adrienkohlbecker/BB816/simulation/README.md

# Simulation

## Address decoding

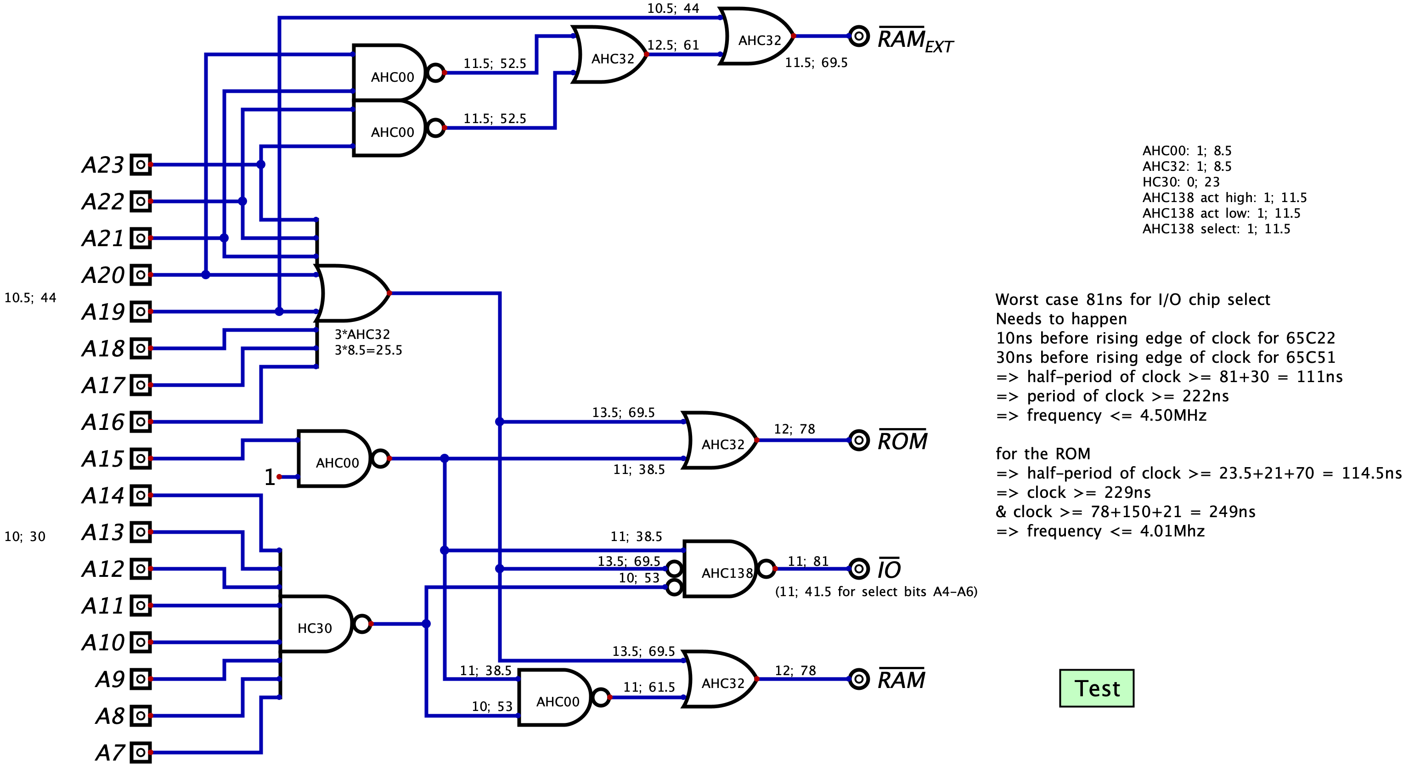
[picture p31: simulation/address.png]
Address decoding


## Glue logic

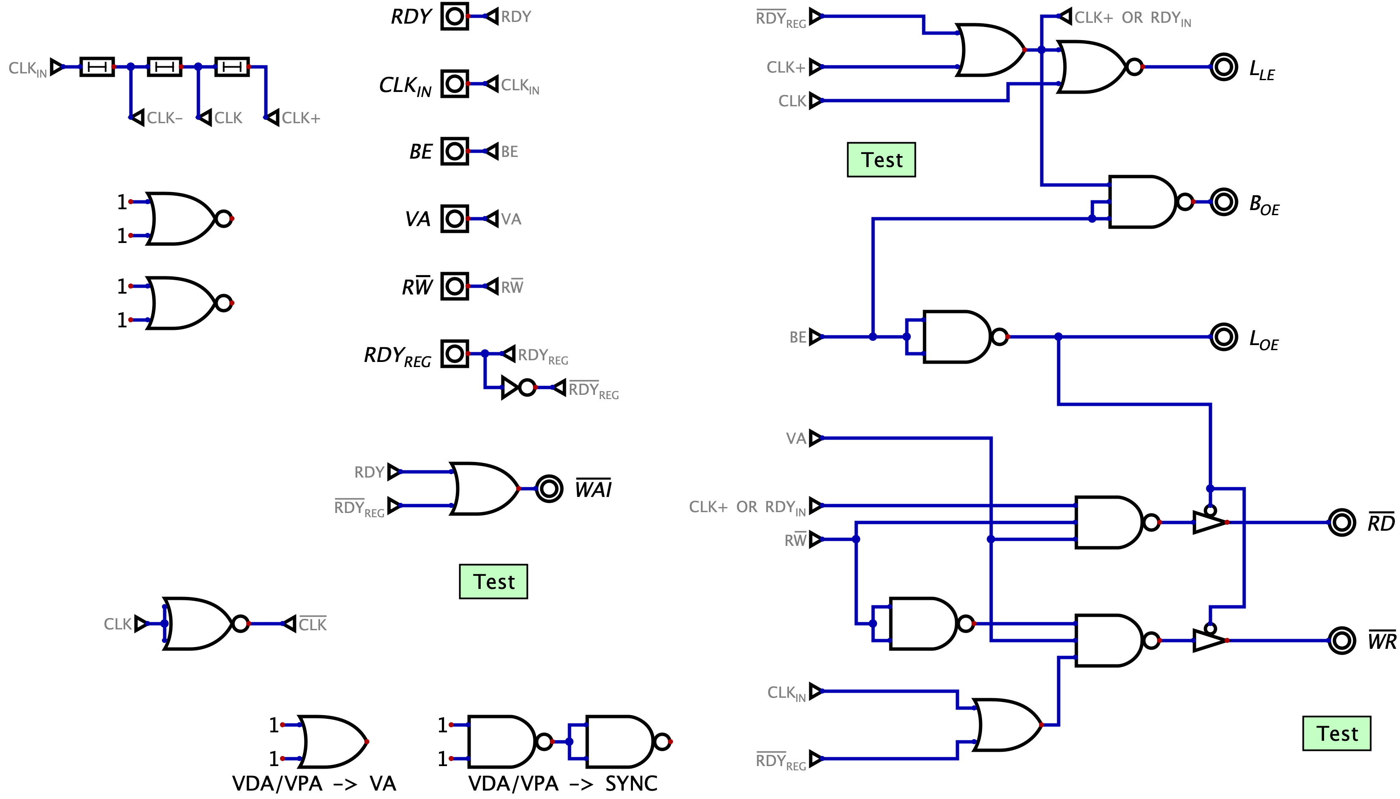
[picture p32: simulation/glue.png]
Glue logic
