adrienkohlbecker/BB816/hardware/breakout/timing/Timing BE.png

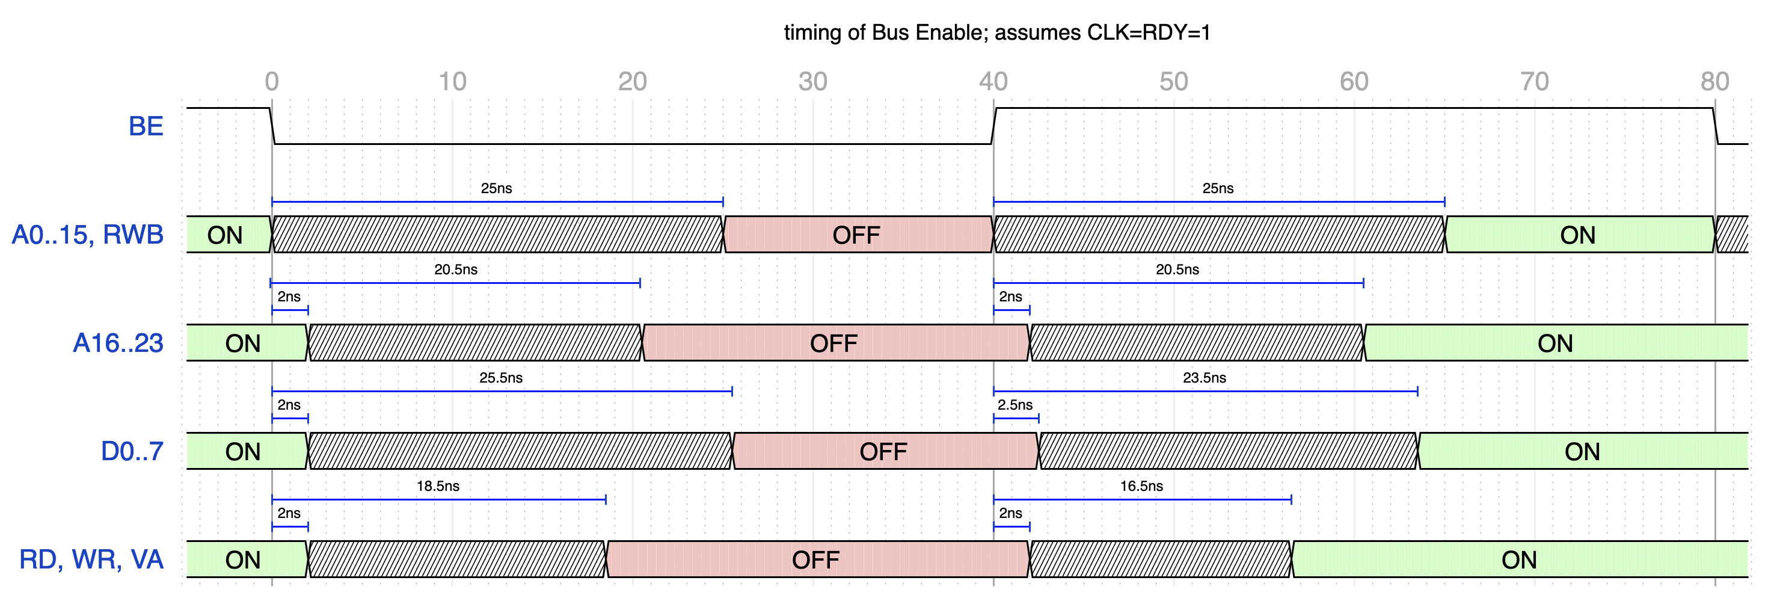
hardware/breakout/timing/Timing BE.png
