adrienkohlbecker/BB816/hardware/breakout/timing/Timing Main.png

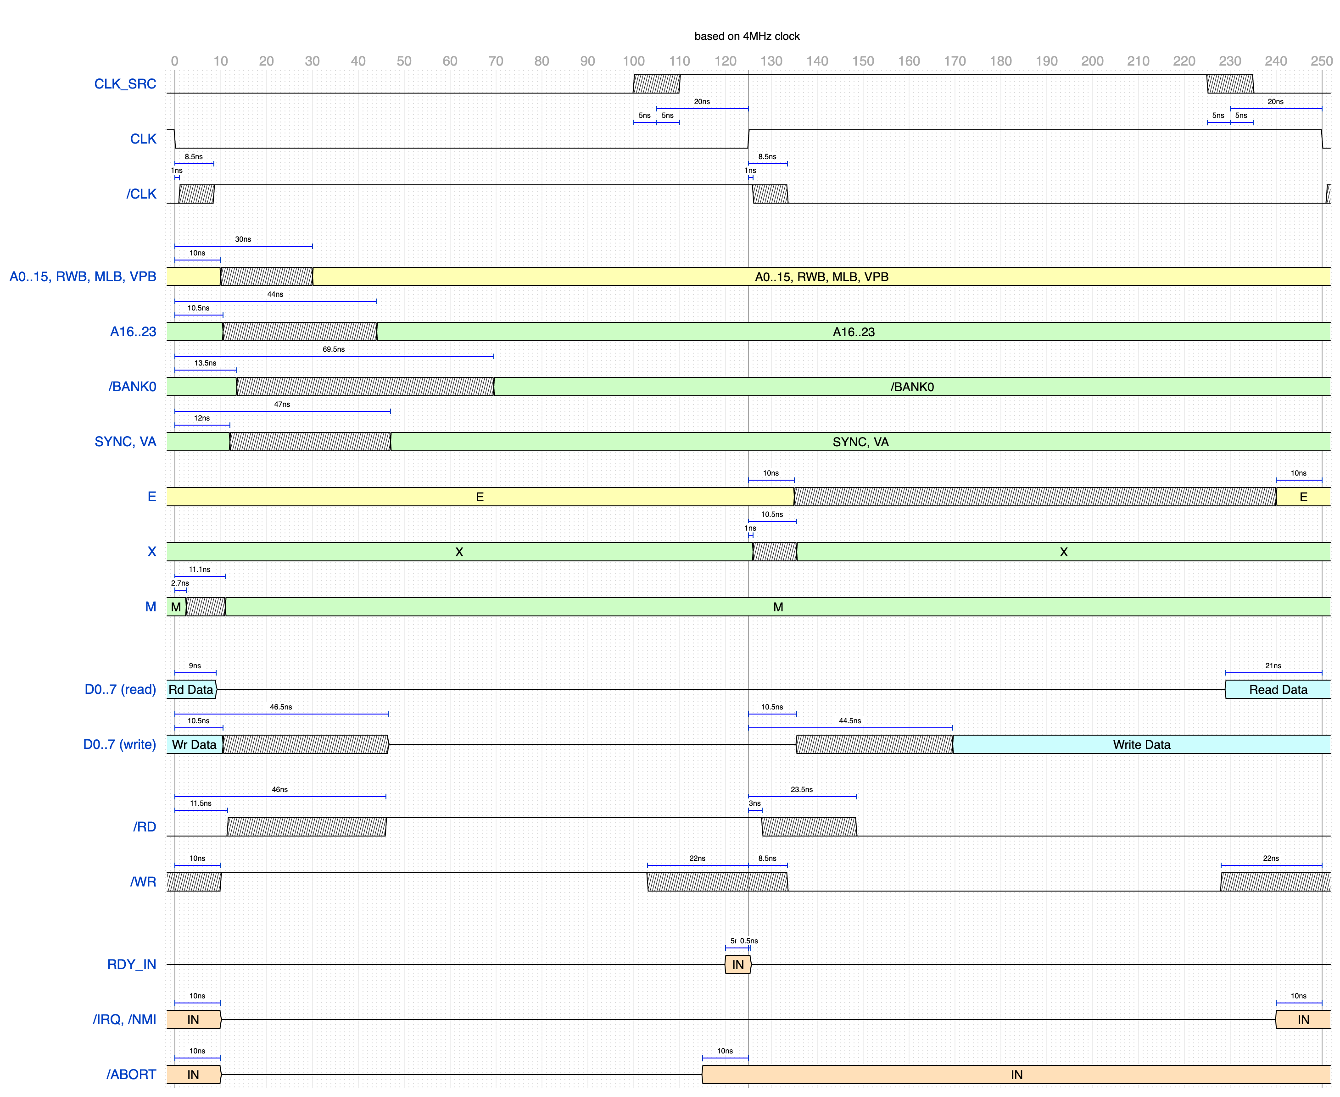
hardware/breakout/timing/Timing Main.png
