adrienkohlbecker/BB816/thumbnails/0.jpg

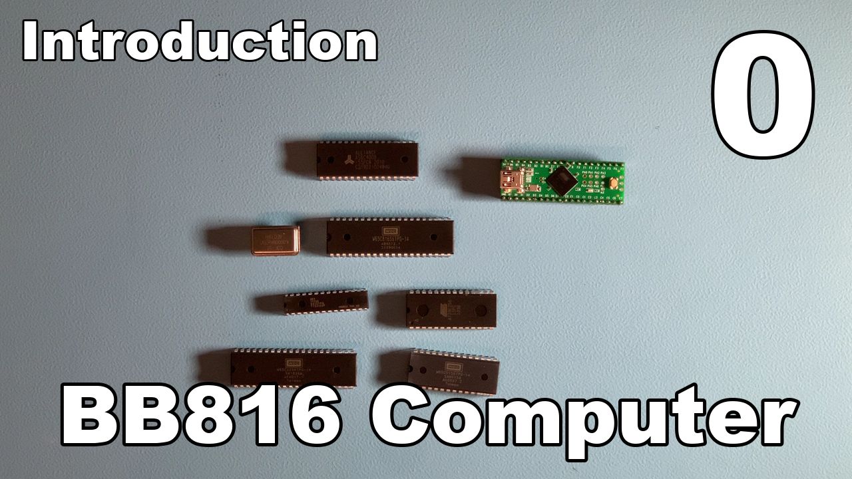
thumbnails/0.jpg
