adrienkohlbecker/BB816/thumbnails/1.jpg

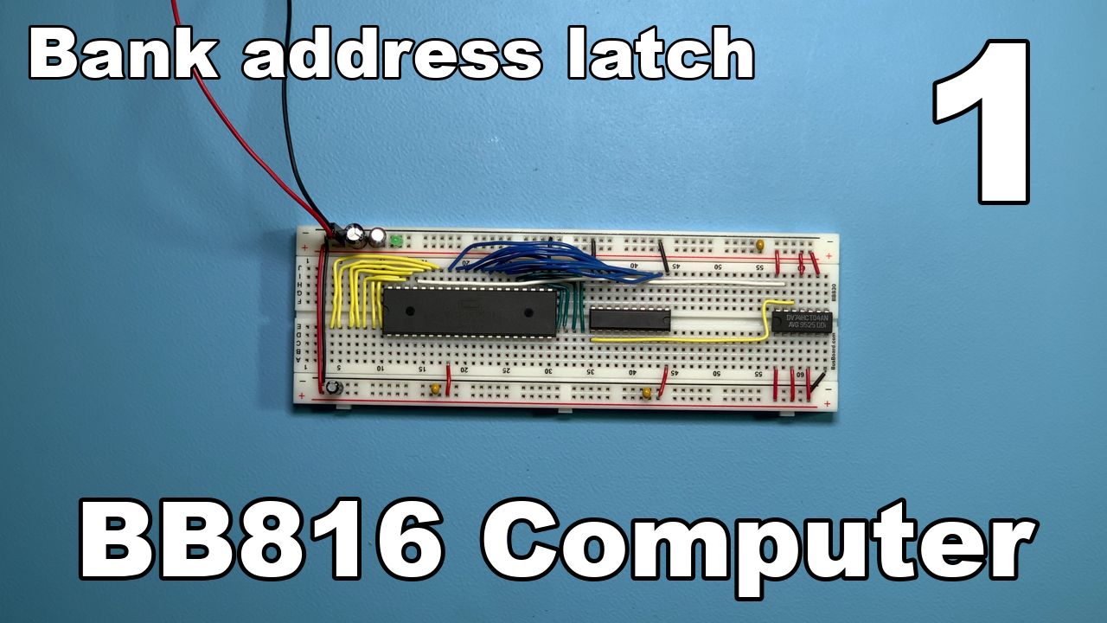
thumbnails/1.jpg
