adrienkohlbecker/BB816/thumbnails/2.jpg

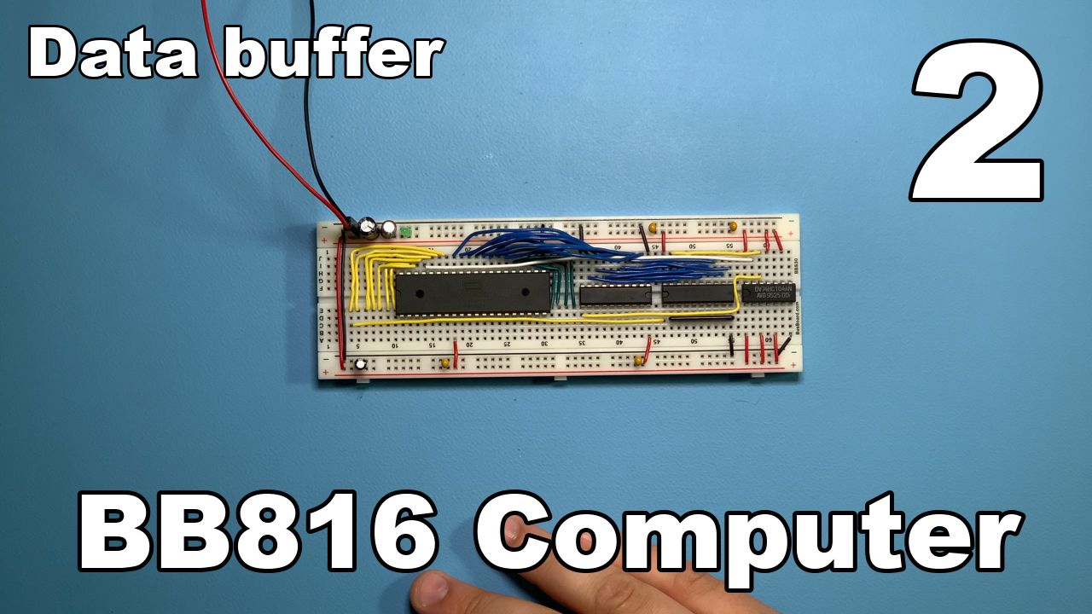
thumbnails/2.jpg
