adrienkohlbecker/BB816/thumbnails/3.jpg

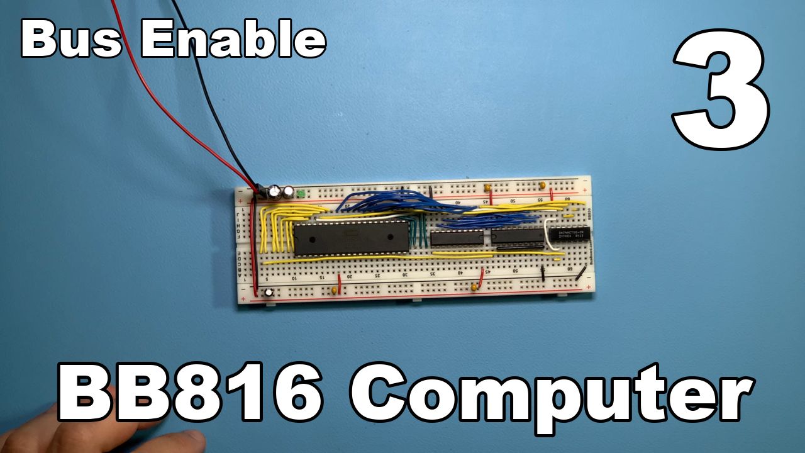
thumbnails/3.jpg
