adrienkohlbecker/BB816/thumbnails/4.jpg

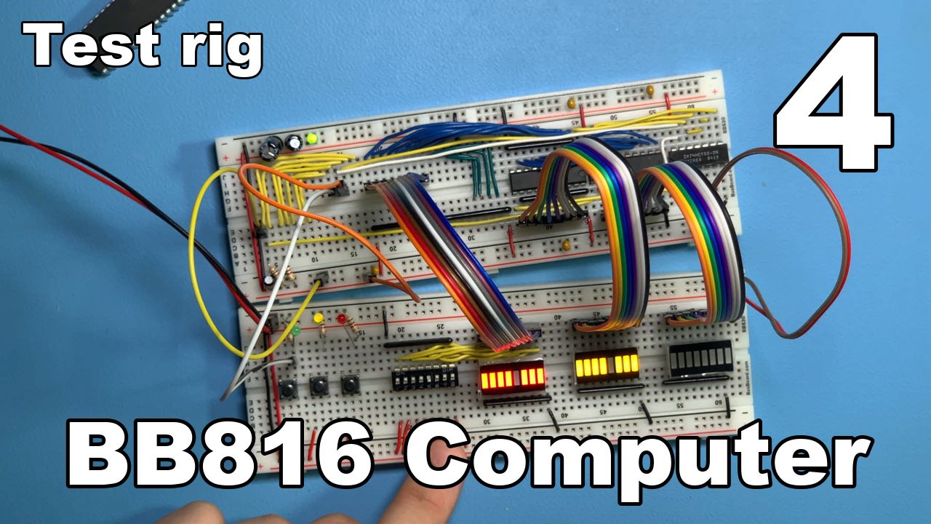
thumbnails/4.jpg
