adrienkohlbecker/BB816/thumbnails/5.jpg

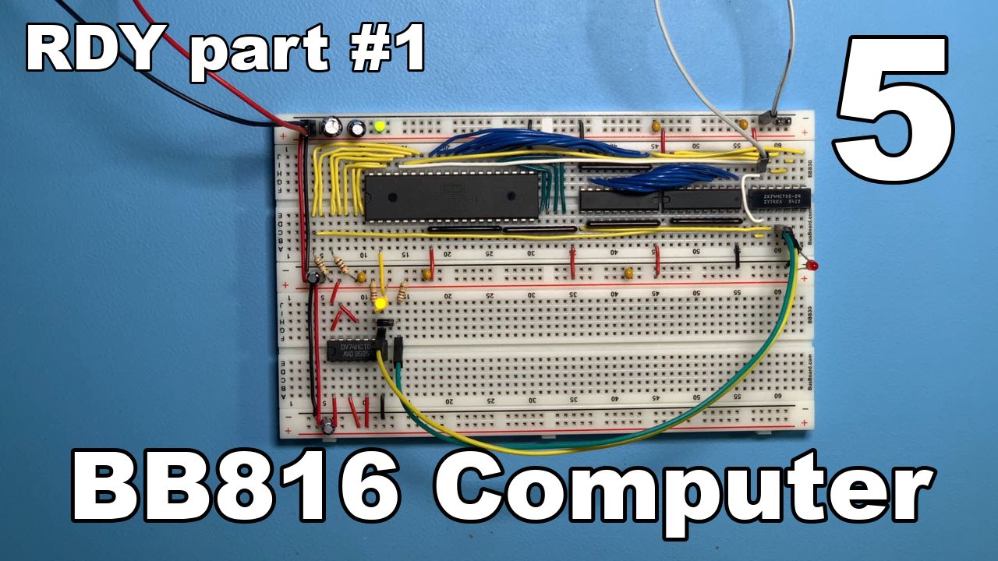
thumbnails/5.jpg
