adrienkohlbecker/BB816/thumbnails/6.jpg

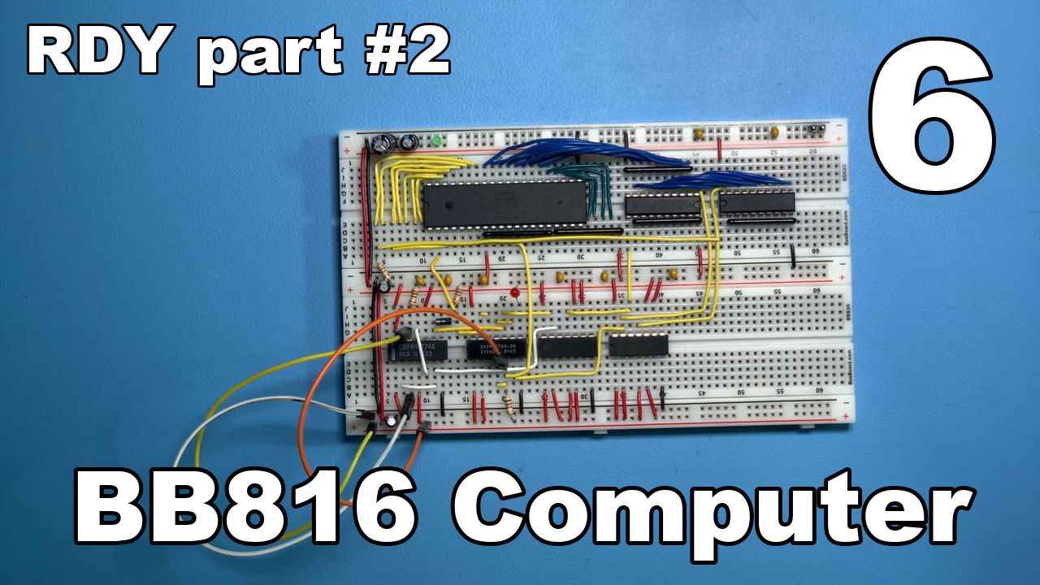
thumbnails/6.jpg
