adrienkohlbecker/BB816/thumbnails/7.jpg

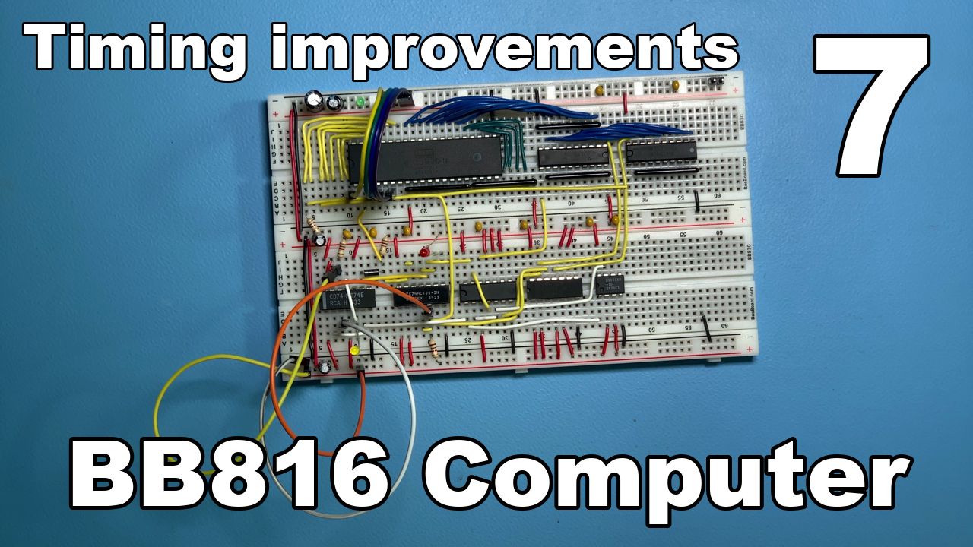
thumbnails/7.jpg
