adrienkohlbecker/BB816/thumbnails/8.jpg

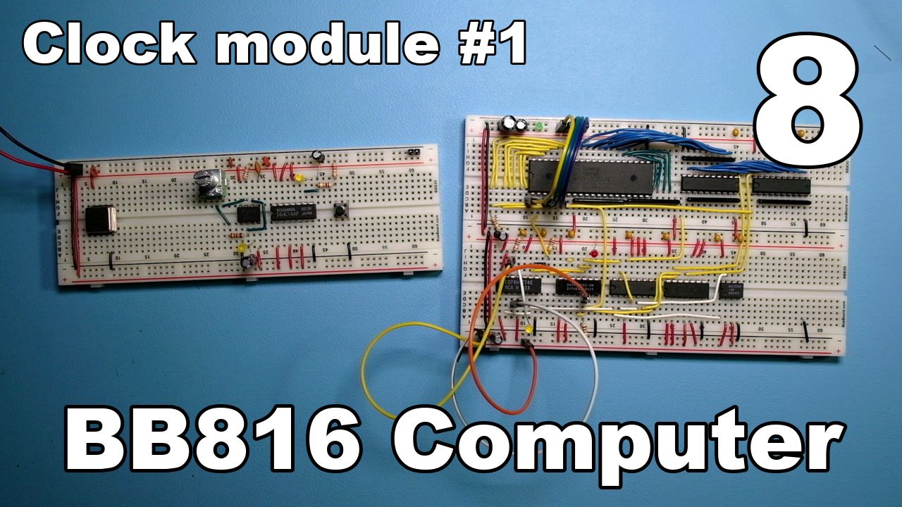
thumbnails/8.jpg
