adrienkohlbecker/BB816/thumbnails/9.jpg

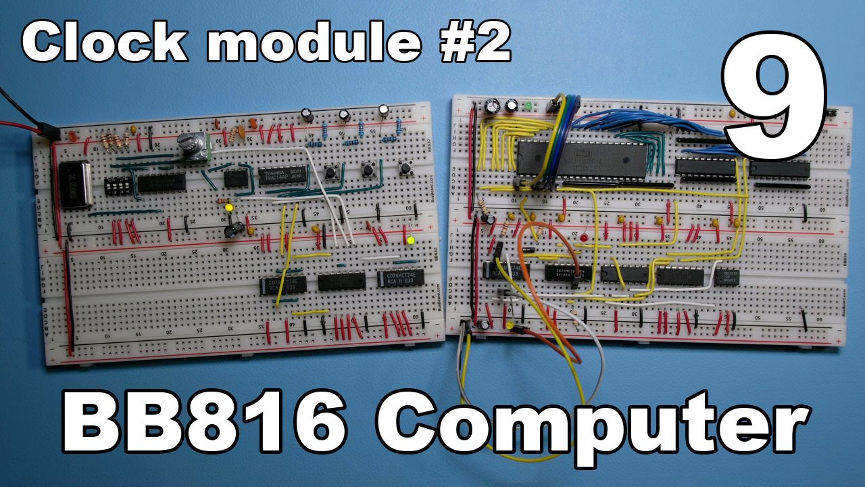
thumbnails/9.jpg
