adrienkohlbecker/BB816/thumbnails/10.jpg

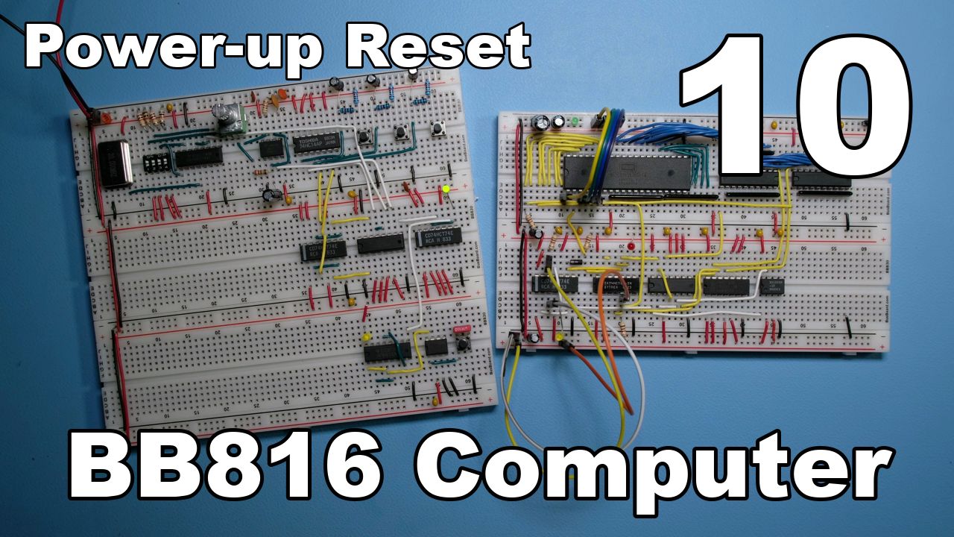
thumbnails/10.jpg
