adrienkohlbecker/BB816/thumbnails/11.jpg

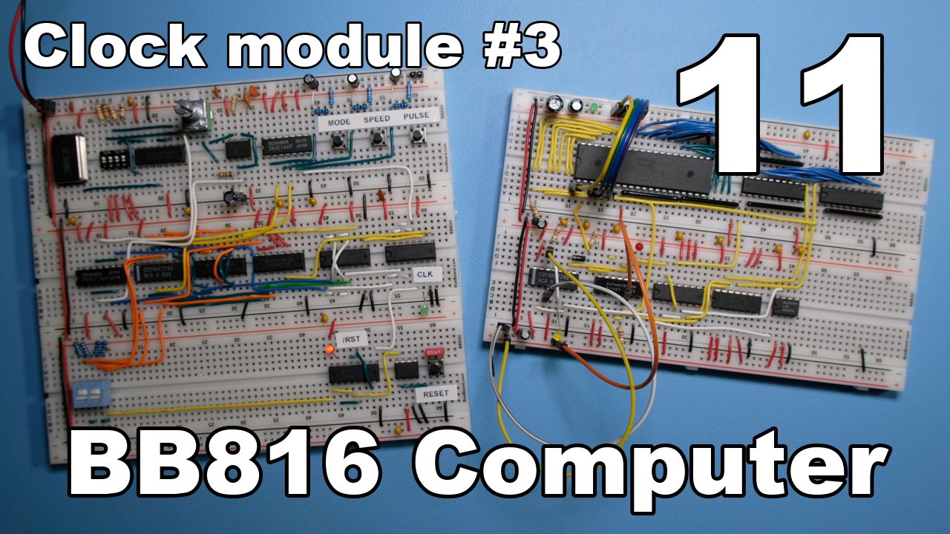
thumbnails/11.jpg
