adrienkohlbecker/BB816/thumbnails/12.jpg

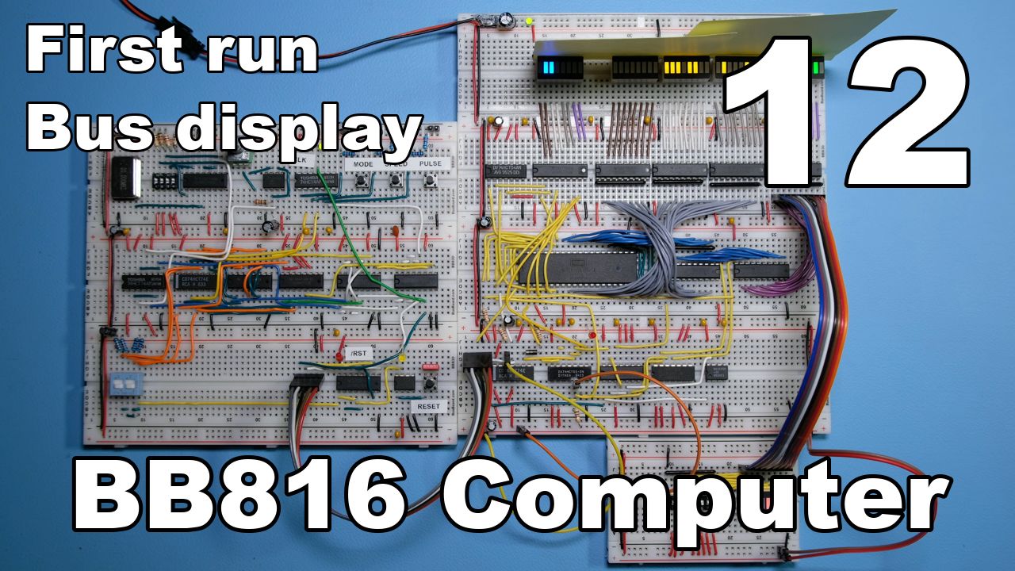
thumbnails/12.jpg
