adrienkohlbecker/BB816/thumbnails/13.jpg

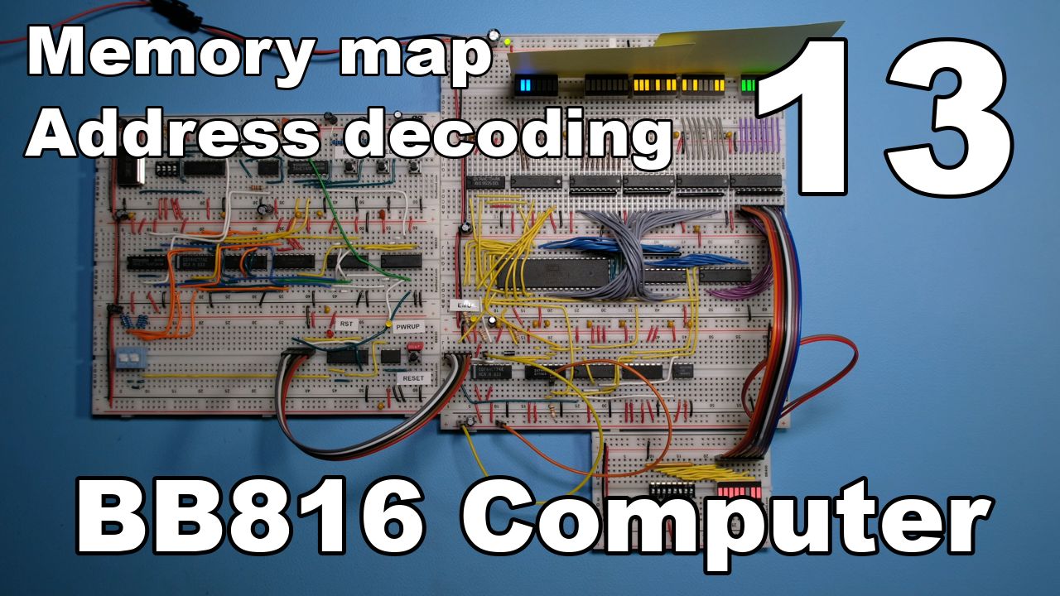
thumbnails/13.jpg
