adrienkohlbecker/BB816/thumbnails/14.jpg

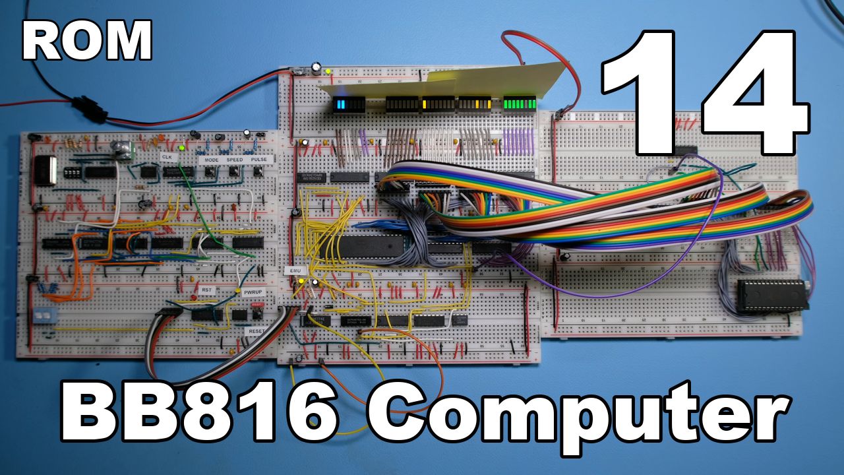
thumbnails/14.jpg
