adrienkohlbecker/BB816/thumbnails/15.jpg

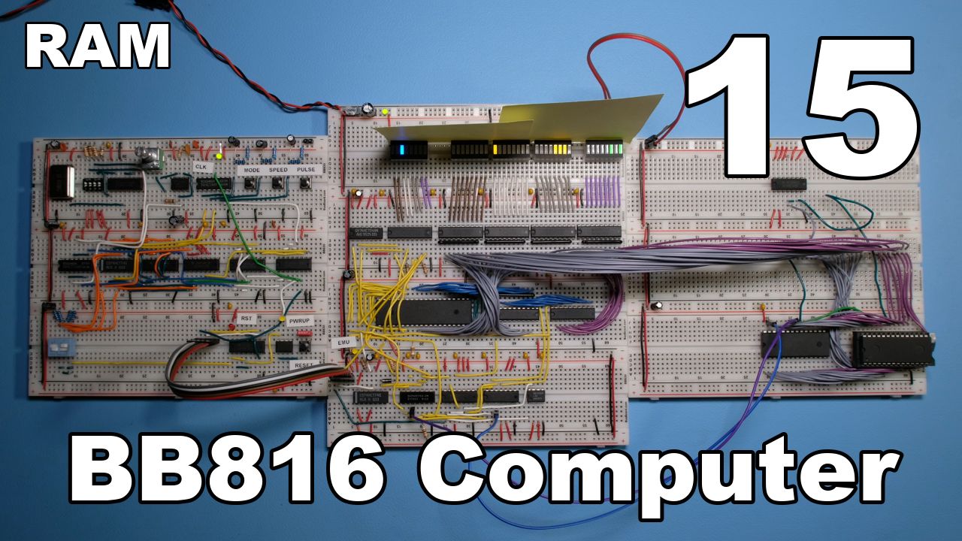
thumbnails/15.jpg
