adrienkohlbecker/BB816/thumbnails/16.jpg

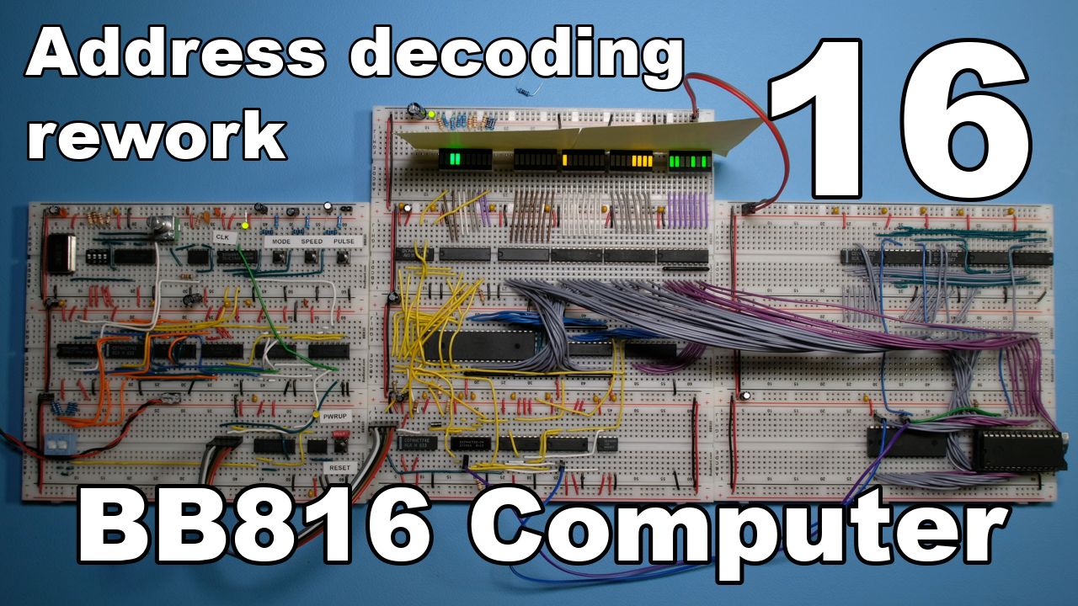
thumbnails/16.jpg
