adrienkohlbecker/BB816/thumbnails/17.jpg

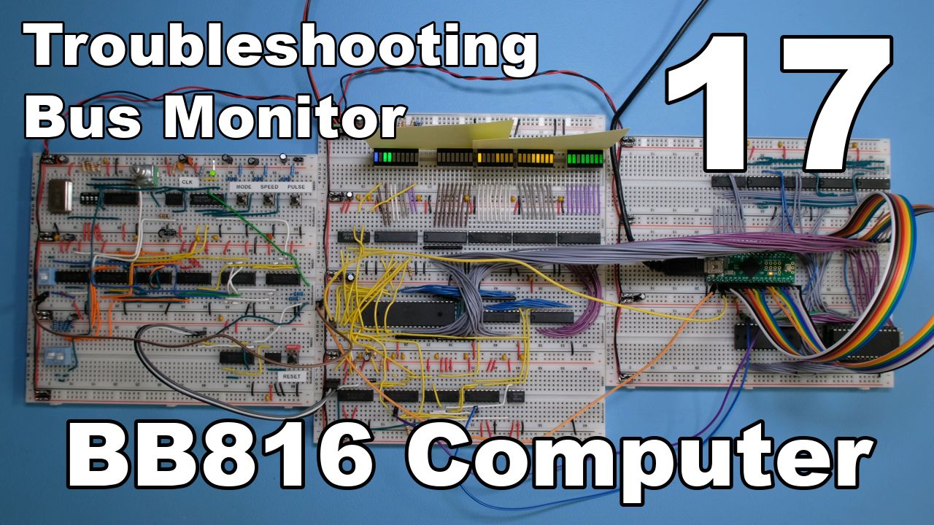
thumbnails/17.jpg
