adrienkohlbecker/BB816/thumbnails/18.jpg

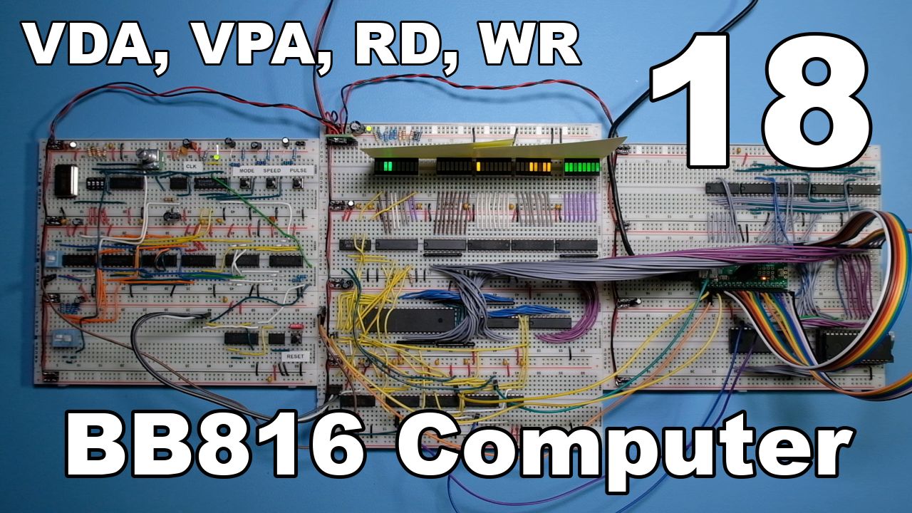
thumbnails/18.jpg
