adrienkohlbecker/BB816/thumbnails/19.jpg

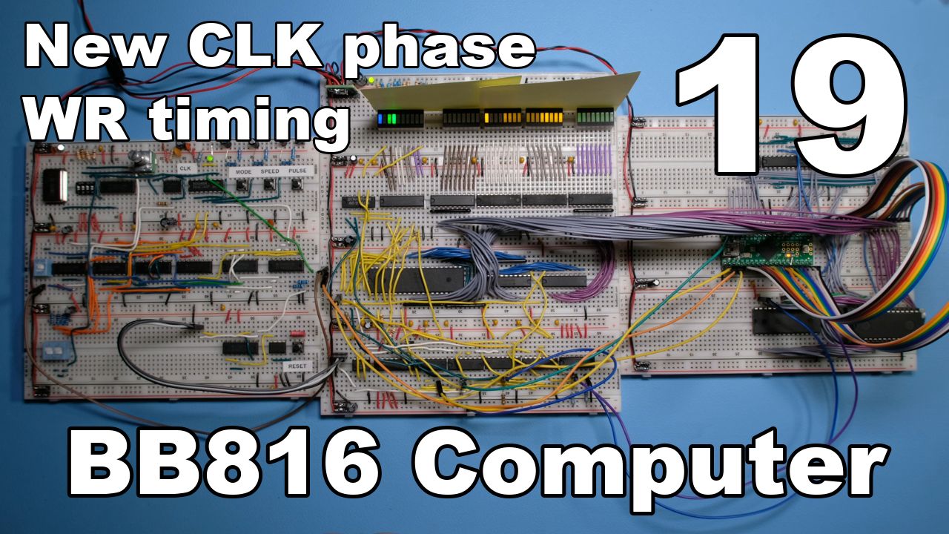
thumbnails/19.jpg
