adrienkohlbecker/BB816/thumbnails/20.jpg

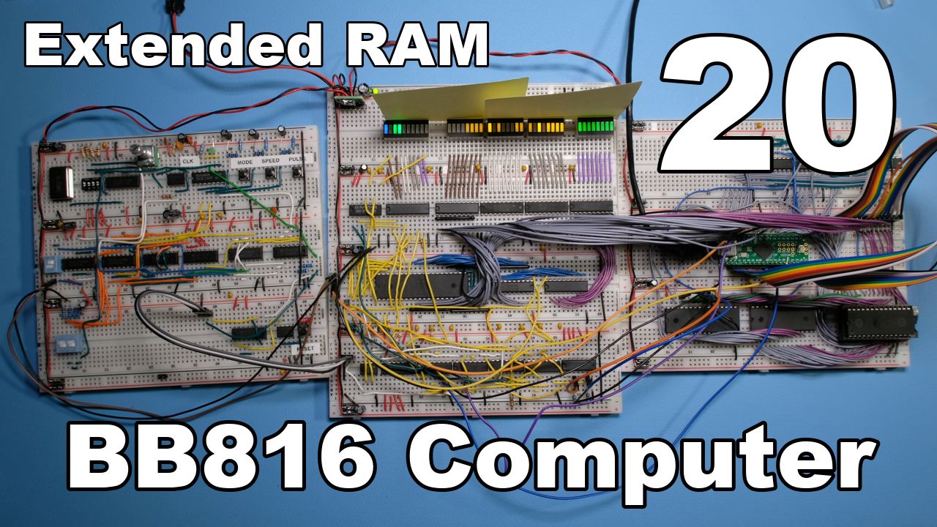
thumbnails/20.jpg
