adrienkohlbecker/BB816/thumbnails/21.jpg

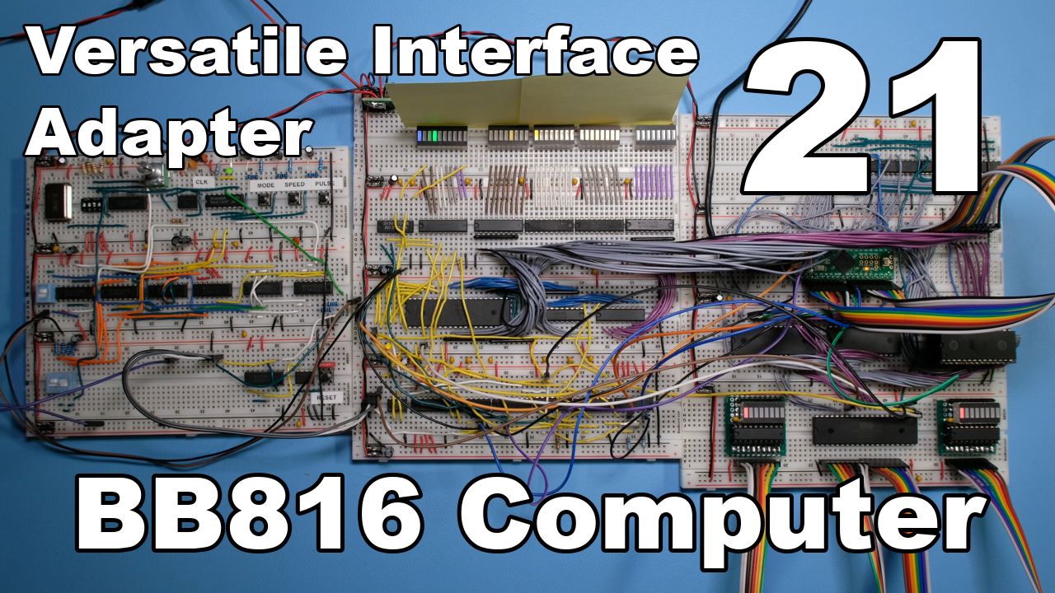
thumbnails/21.jpg
