adrienkohlbecker/BB816/thumbnails/22.jpg

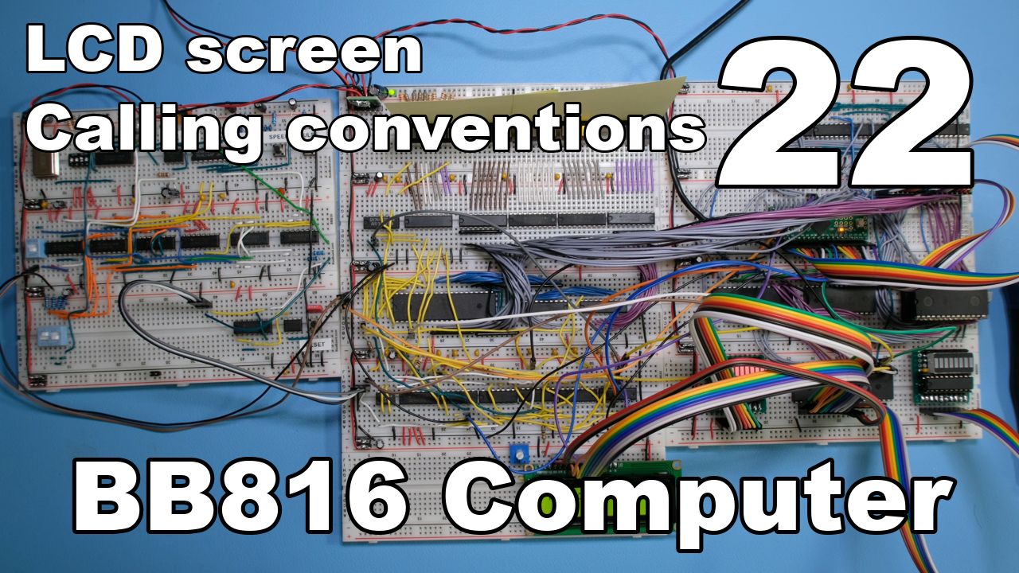
thumbnails/22.jpg
