adrienkohlbecker/BB816/thumbnails/23.jpg

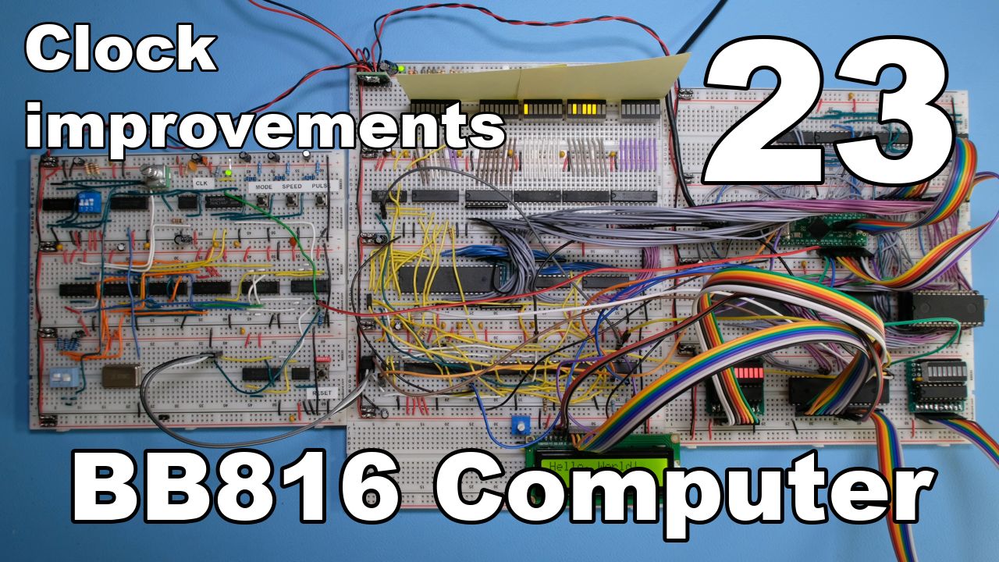
thumbnails/23.jpg
