adrienkohlbecker/BB816/thumbnails/24.jpg

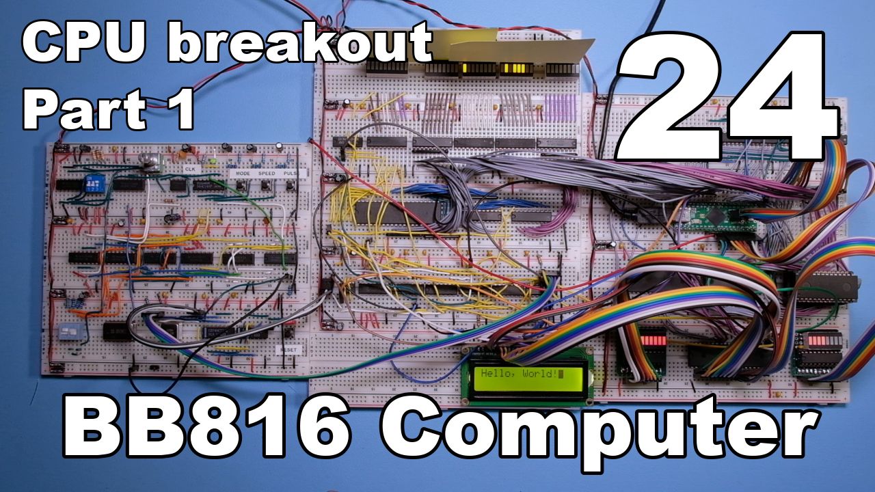
thumbnails/24.jpg
