adrienkohlbecker/BB816/thumbnails/25.jpg

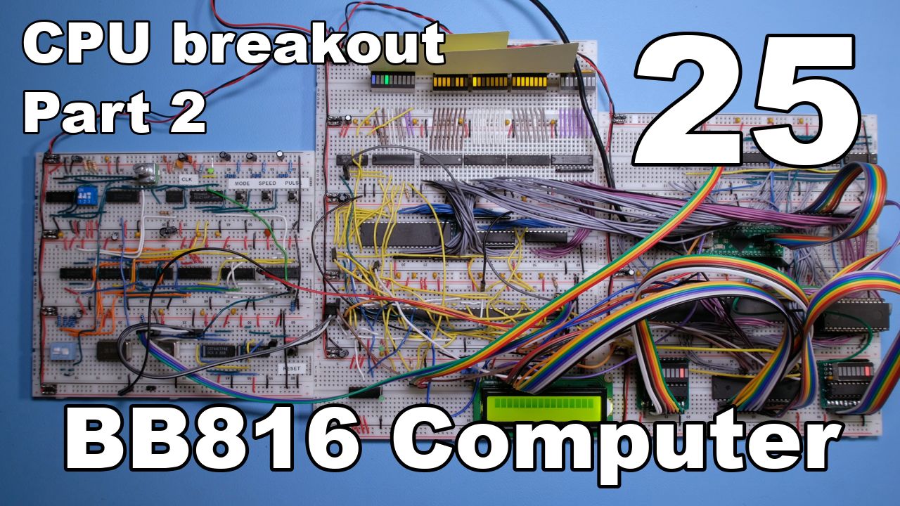
thumbnails/25.jpg
