adrienkohlbecker/BB816/thumbnails/26.jpg

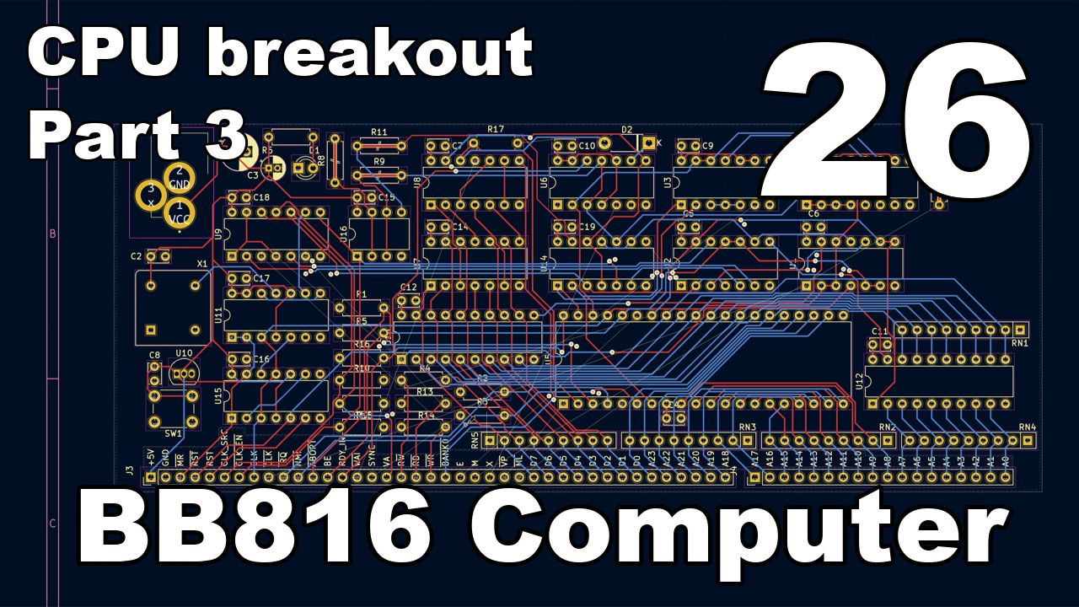
thumbnails/26.jpg
