adrienkohlbecker/BB816/thumbnails/27.jpg

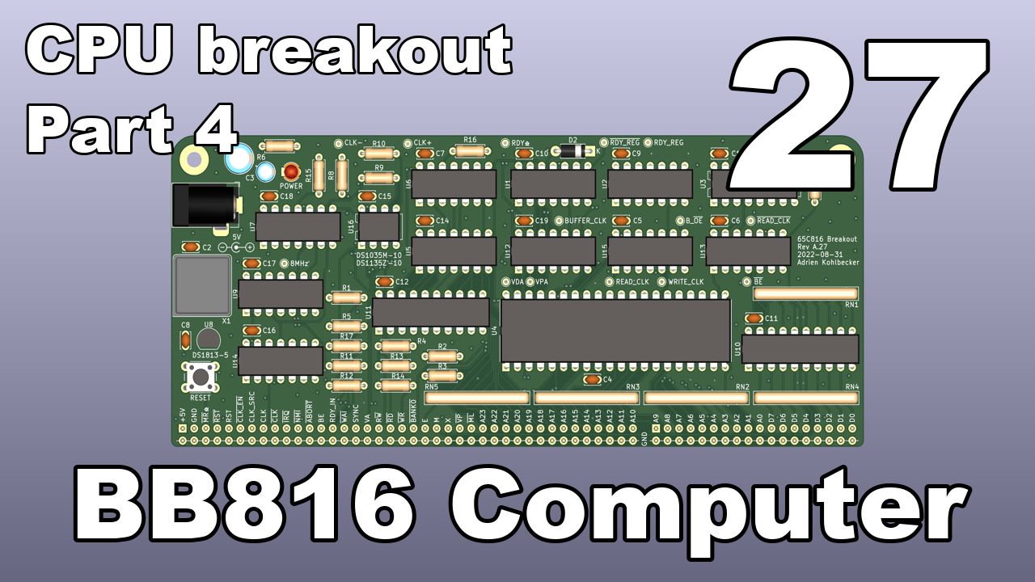
thumbnails/27.jpg
