adrienkohlbecker/BB816/thumbnails/28.jpg

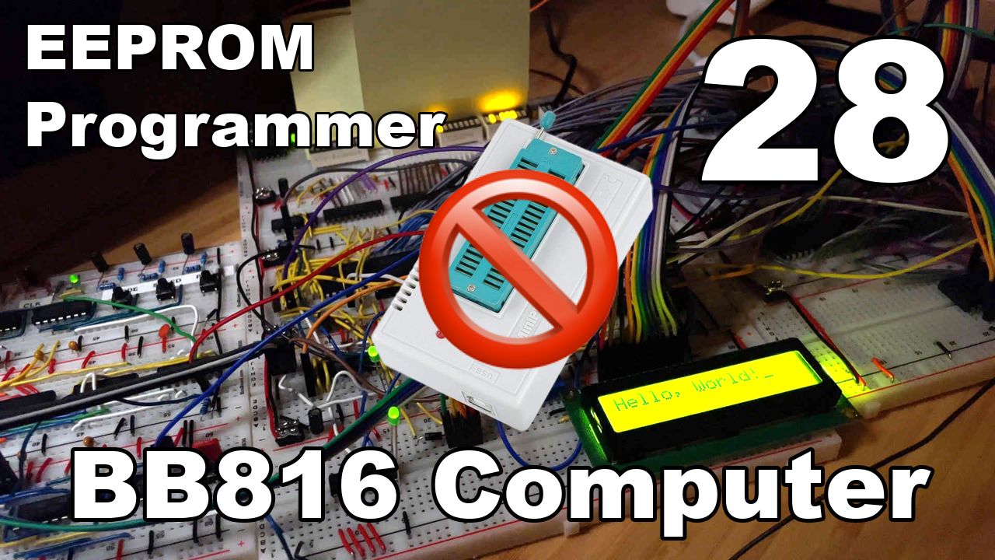
thumbnails/28.jpg
