adrienkohlbecker/BB816/thumbnails/29.jpg

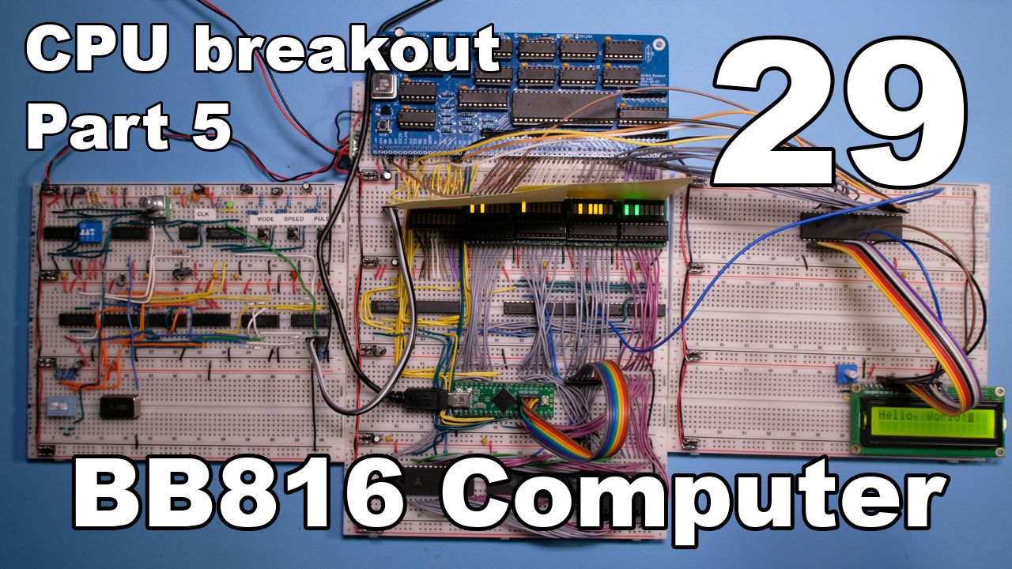
thumbnails/29.jpg
