adrienkohlbecker/BB816/thumbnails/30.jpg

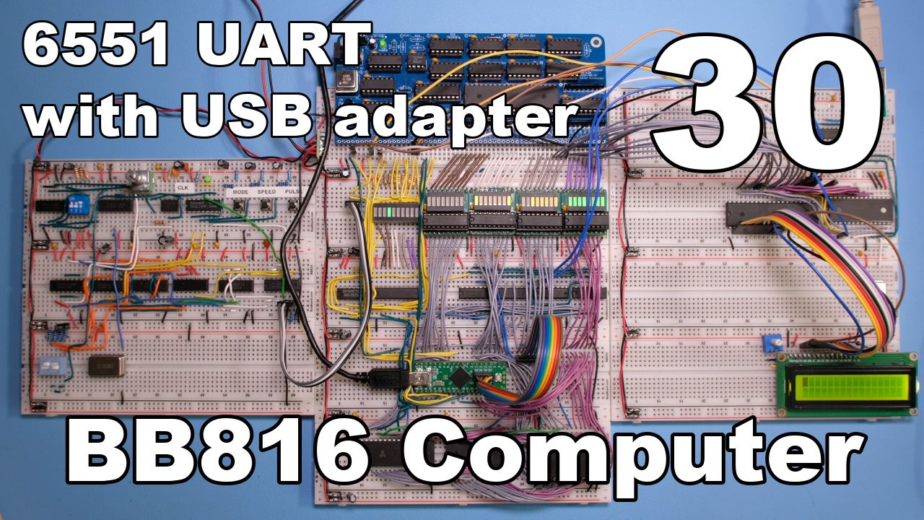
thumbnails/30.jpg
