adrienkohlbecker/BB816/thumbnails/31.jpg

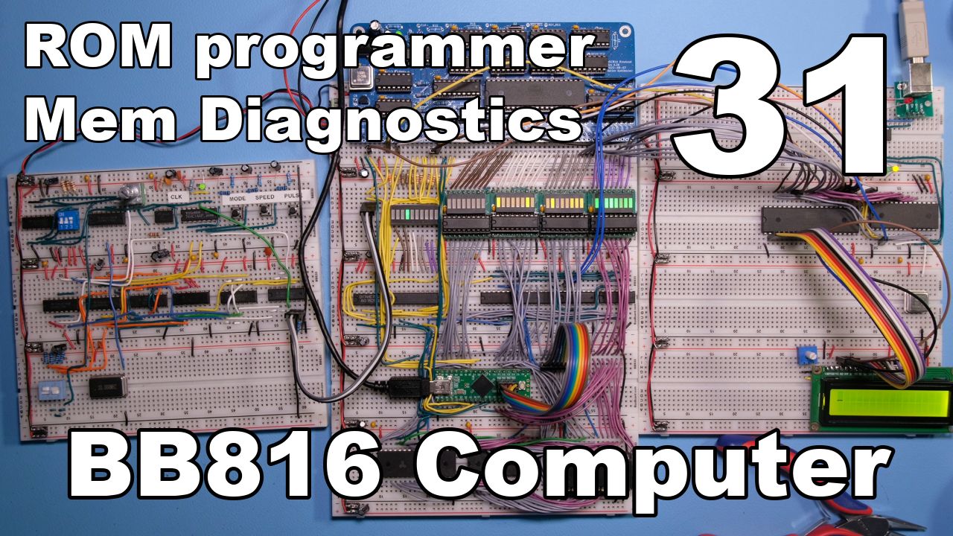
thumbnails/31.jpg
