adrienkohlbecker/BB816/thumbnails/32.jpg

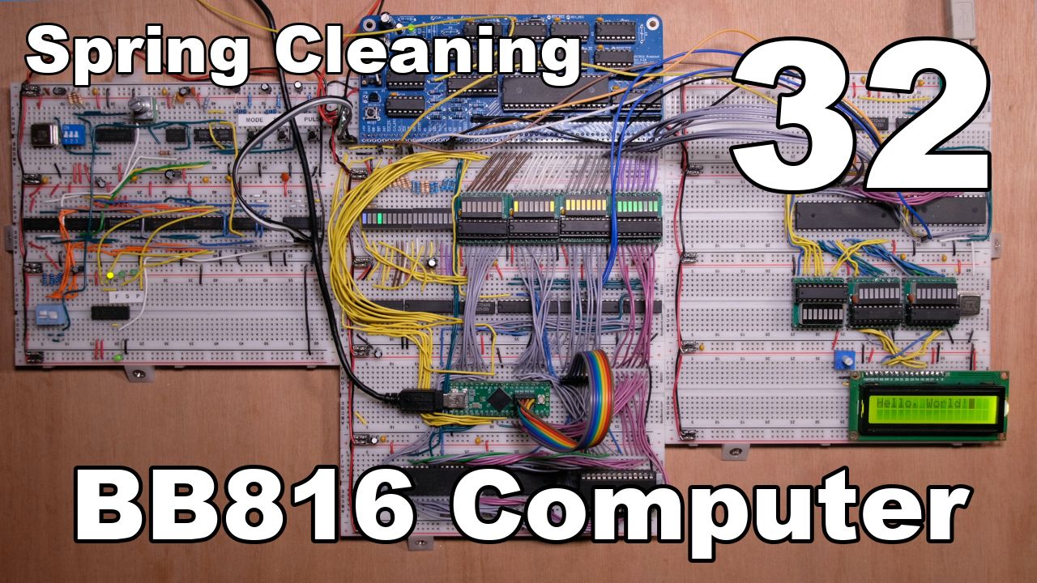
thumbnails/32.jpg
