adrienkohlbecker/BB816/hardware/debug_leds/3d/BAR-8-RYG.step

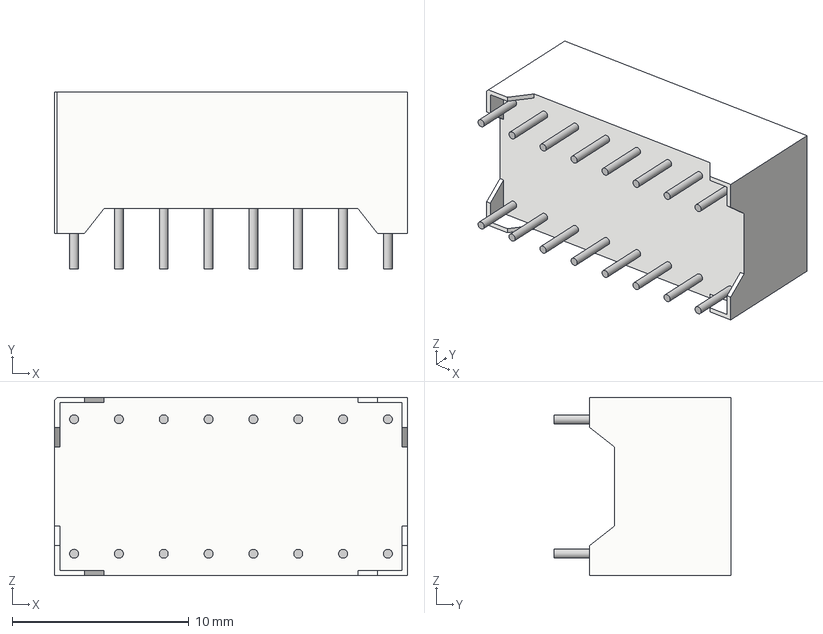
[picture p68: CAD file, 2023-08-10]
hardware/debug_leds/3d/BAR-8-RYG.step
20.0 x 10.0 x 10.1 mm
LED Bar Graph Red LDA-B8ZX v1 x 2
LED Bar Graph Red LDA-B8ZX v002 x 2
LED Bar Graph Red LDA-B8ZX v003 x 2
LED Bar Graph Red LDA-B8ZX v004 x 2
LED Bar Graph Red LDA-B8ZX v005 x 2
LED Bar Graph Red LDA-B8ZX v006 x 2
LED Bar Graph Red LDA-B8ZX v007 x 2
LED Bar Graph Red LDA-B8ZX v008 x 2
LED Bar Graph Red LDA-B8ZX v009 x 2
LED Bar Graph Red LDA-B8ZX v010 x 2
LED Bar Graph Red LDA-B8ZX v011 x 2
LED Bar Graph Red LDA-B8ZX v012 x 2
LED Bar Graph Red LDA-B8ZX v013 x 2
LED Bar Graph Red LDA-B8ZX v014 x 2
LED Bar Graph Red LDA-B8ZX v015 x 2
LED Bar Graph Red LDA-B8ZX v016 x 2
LED Bar Graph Red LDA-B8ZX v017 x 2
LED Bar Graph Red LDA-B8ZX v018 x 2
LED Bar Graph Red LDA-B8ZX v019 x 2
LED Bar Graph Red LDA-B8ZX v020 x 2
LED Bar Graph Red LDA-B8ZX v021 x 2
LED Bar Graph Red LDA-B8ZX v022 x 2
LED Bar Graph Red LDA-B8ZX v023 x 2
LED Bar Graph Red LDA-B8ZX v024 x 2
LED Bar Graph Red LDA-B8ZX v025 x 2
