adrienkohlbecker/BB816/hardware/debug_leds/3d/BAR-10-BRYG.step

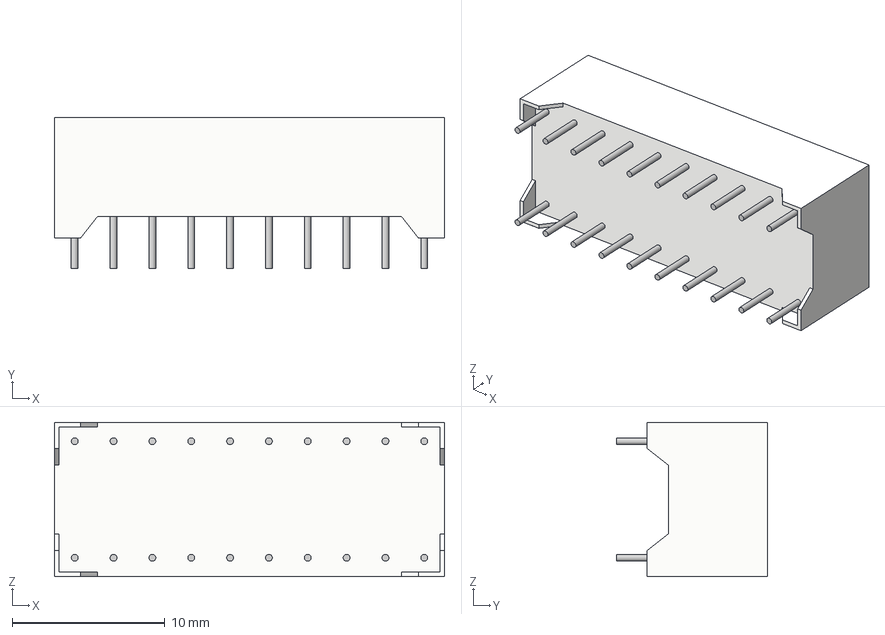
[picture p69: CAD file, 2023-08-10]
hardware/debug_leds/3d/BAR-10-BRYG.step
25.5 x 9.90 x 10.1 mm
LED Bar Graph 102510 Coloured v5
LED Bar Graph 102510 Coloured v006
LED Bar Graph 102510 Coloured v007
LED Bar Graph 102510 Coloured v008
LED Bar Graph 102510 Coloured v009
LED Bar Graph 102510 Coloured v010
LED Bar Graph 102510 Coloured v011
LED Bar Graph 102510 Coloured v012
LED Bar Graph 102510 Coloured v013
LED Bar Graph 102510 Coloured v014
LED Bar Graph 102510 Coloured v015
LED Bar Graph 102510 Coloured v016
LED Bar Graph 102510 Coloured v017
LED Bar Graph 102510 Coloured v018
LED Bar Graph 102510 Coloured v019
LED Bar Graph 102510 Coloured v020
LED Bar Graph 102510 Coloured v021
LED Bar Graph 102510 Coloured v022
LED Bar Graph 102510 Coloured v023
LED Bar Graph 102510 Coloured v024
LED Bar Graph 102510 Coloured v025
LED Bar Graph 102510 Coloured v026
LED Bar Graph 102510 Coloured v027
LED Bar Graph 102510 Coloured v028
LED Bar Graph 102510 Coloured v029
LED Bar Graph 102510 Coloured v030
LED Bar Graph 102510 Coloured v031
LED Bar Graph 102510 Coloured v032
LED Bar Graph 102510 Coloured v033
LED Bar Graph 102510 Coloured v034
LED Bar Graph 102510 Coloured v035
