adrienkohlbecker/BB816/hardware/debug_leds/debug_leds.kicad_pcb

## KiCad design hardware/debug_leds/debug_leds.kicad_pcb (2023-08-10)

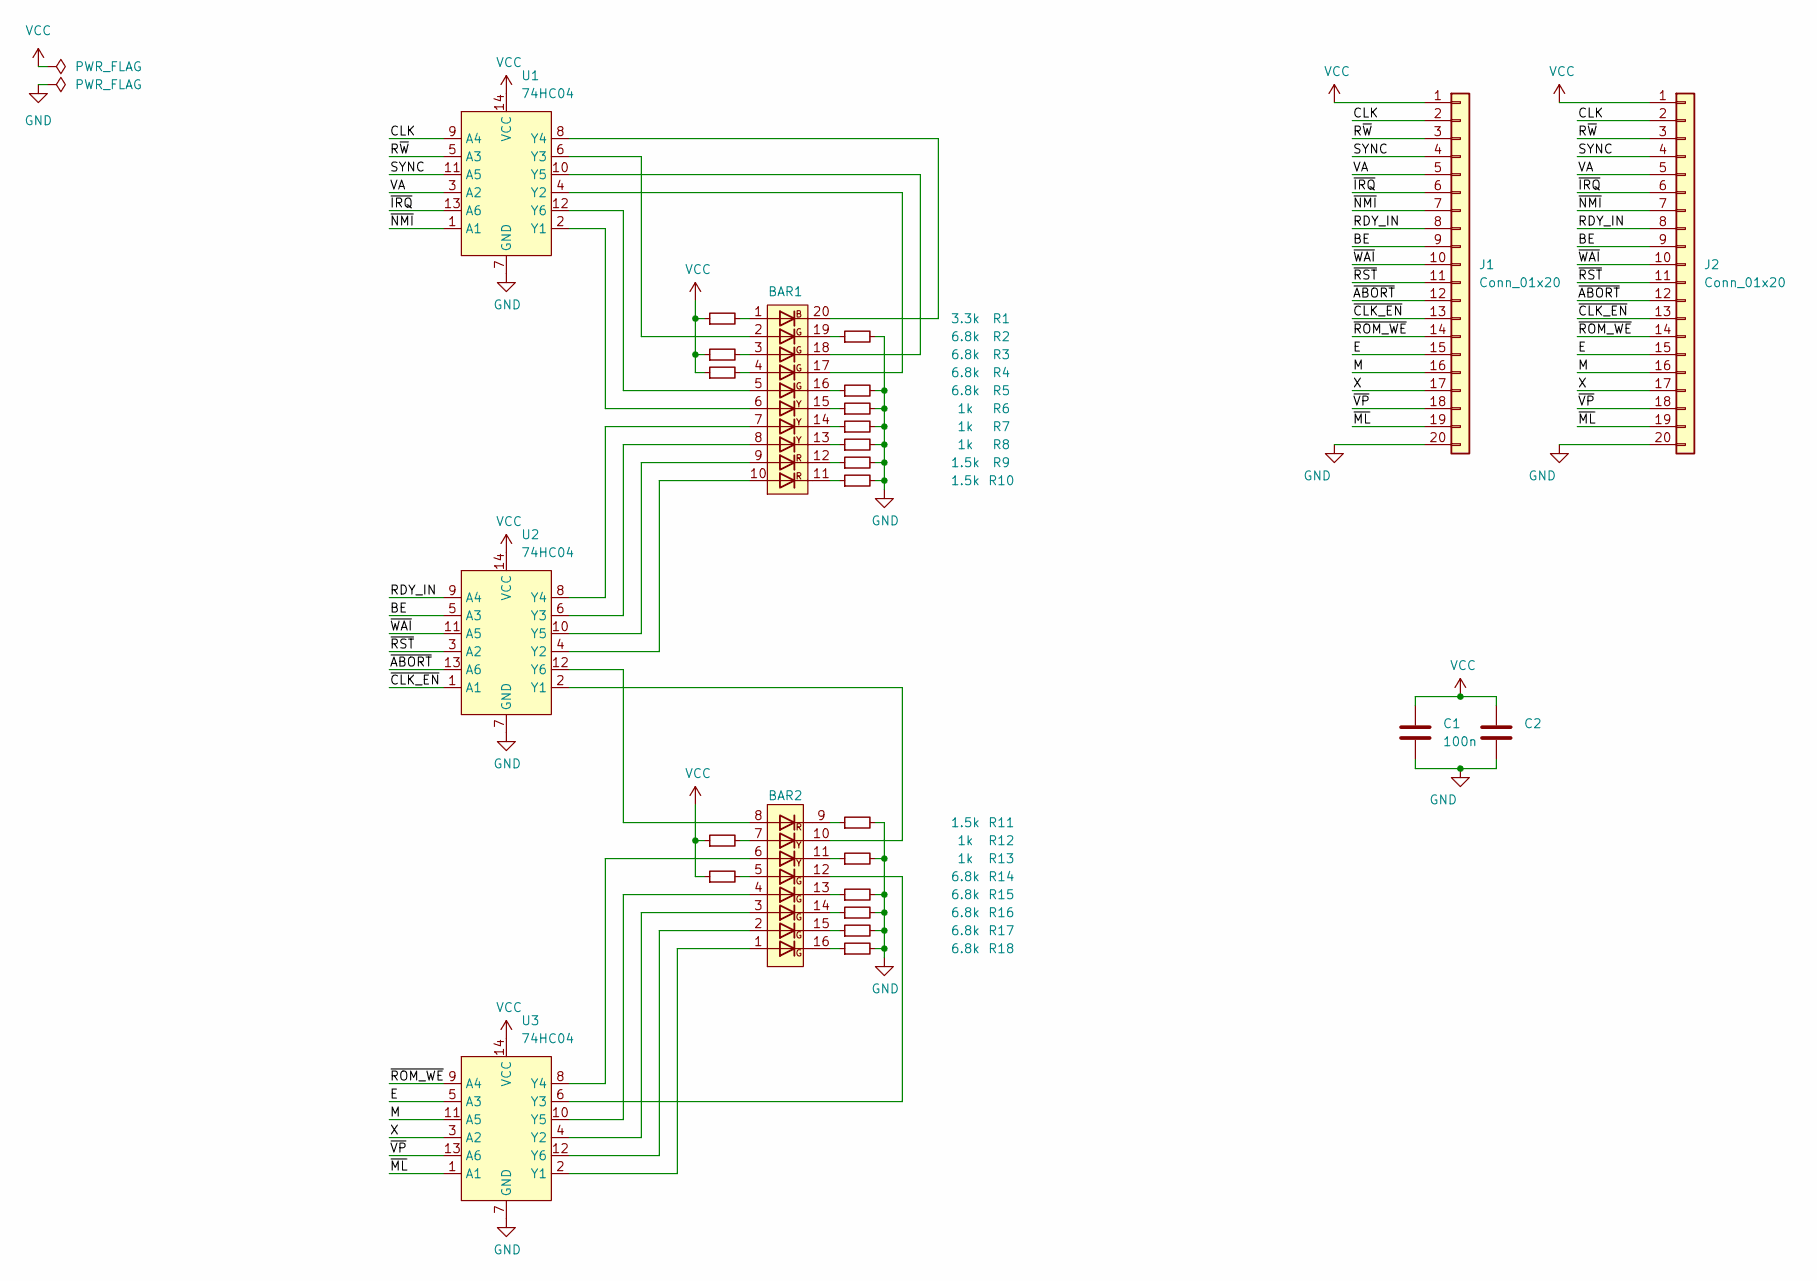
[picture p70: schematic debug_leds.kicad_sch, 65C816 Debug LEDs]

Parts:
BAR1: LED-Array-10-BGYR; DIP-20_W7.62mm
BAR2: LED-Array-8-GYR; DIP-16_W7.62mm
C1, C2: 100n; C_Disc_D3.0mm_W1.6mm_P2.50mm
J1, J2: Conn_01x20; PinHeader_1x20_P2.54mm_Vertical
R1: 3.3k; R_1206_3216Metric_Pad1.30x1.75mm_HandSolder
R2, R3, R4, R5, R14, R15, R16, R17, R18: 6.8k; R_1206_3216Metric_Pad1.30x1.75mm_HandSolder
R6, R7, R8, R12, R13: 1k; R_1206_3216Metric_Pad1.30x1.75mm_HandSolder
R9, R10, R11: 1.5k; R_1206_3216Metric_Pad1.30x1.75mm_HandSolder
U1, U2, U3: 74HC04; DIP-14_W7.62mm

Connections:
/BE: J1.9, J2.9, U2.5 (A3)
/CLK: J1.2, J2.2, U1.9 (A4)
/E: J1.15, J2.15, U3.5 (A3)
/M: J1.16, J2.16, U3.11 (A5)
/RDY_IN: J1.8, J2.8, U2.9 (A4)
/R~W: J1.3, J2.3, U1.5 (A3)
/SYNC: J1.4, J2.4, U1.11 (A5)
/VA: J1.5, J2.5, U1.3 (A2)
/X: J1.17, J2.17, U3.3 (A2)
/~ABORT: J1.12, J2.12, U2.13 (A6)
/~CLK_EN: J1.13, J2.13, U2.1 (A1)
/~IRQ: J1.6, J2.6, U1.13 (A6)
/~ML: J1.19, J2.19, U3.1 (A1)
/~NMI: J1.7, J2.7, U1.1 (A1)
/~ROM_WE: J1.14, J2.14, U3.9 (A4)
/~RST: J1.11, J2.11, U2.3 (A2)
/~VP: J1.18, J2.18, U3.13 (A6)
/~WAI: J1.10, J2.10, U2.11 (A5)
GND: C1.2, C2.2, J1.20, J2.20, R2.2, R5.2, R6.2, R7.2, R8.2, R9.2, R10.2, R11.2, R13.2, R15.2, R16.2, R17.2, R18.2, U1.7 (GND), U2.7 (GND), U3.7 (GND)
unnamed: BAR1.1 (A), R1.2
unnamed: BAR1.3 (A), R3.2
unnamed: BAR1.4 (A), R4.2
unnamed: BAR1.11 (K), R10.1
unnamed: BAR1.12 (K), R9.1
unnamed: BAR1.13 (K), R8.1
unnamed: BAR1.14 (K), R7.1
unnamed: BAR1.15 (K), R6.1
unnamed: BAR1.16 (K), R5.1
unnamed: BAR1.19 (K), R2.1
unnamed: BAR2.5 (A), R14.2
unnamed: BAR2.7 (A), R12.2
unnamed: BAR2.9 (K), R11.1
unnamed: BAR2.11 (K), R13.1
unnamed: BAR2.13 (K), R15.1
unnamed: BAR2.14 (K), R16.1
unnamed: BAR2.15 (K), R17.1
unnamed: BAR2.16 (K), R18.1
unnamed: BAR1.6 (A), U1.2 (Y1)
unnamed: BAR1.17 (K), U1.4 (Y2)
unnamed: BAR1.2 (A), U1.6 (Y3)
unnamed: BAR1.20 (K), U1.8 (Y4)
unnamed: BAR1.18 (K), U1.10 (Y5)
unnamed: BAR1.5 (A), U1.12 (Y6)
unnamed: BAR2.10 (K), U2.2 (Y1)
unnamed: BAR1.10 (A), U2.4 (Y2)
unnamed: BAR1.8 (A), U2.6 (Y3)
unnamed: BAR1.7 (A), U2.8 (Y4)
unnamed: BAR1.9 (A), U2.10 (Y5)
unnamed: BAR2.8 (A), U2.12 (Y6)
unnamed: BAR2.1 (A), U3.2 (Y1)
unnamed: BAR2.3 (A), U3.4 (Y2)
unnamed: BAR2.12 (K), U3.6 (Y3)
unnamed: BAR2.6 (A), U3.8 (Y4)
unnamed: BAR2.4 (A), U3.10 (Y5)
unnamed: BAR2.2 (A), U3.12 (Y6)
VCC: C1.1, C2.1, J1.1, J2.1, R1.1, R3.1, R4.1, R12.1, R14.1, U1.14 (VCC), U2.14 (VCC), U3.14 (VCC)

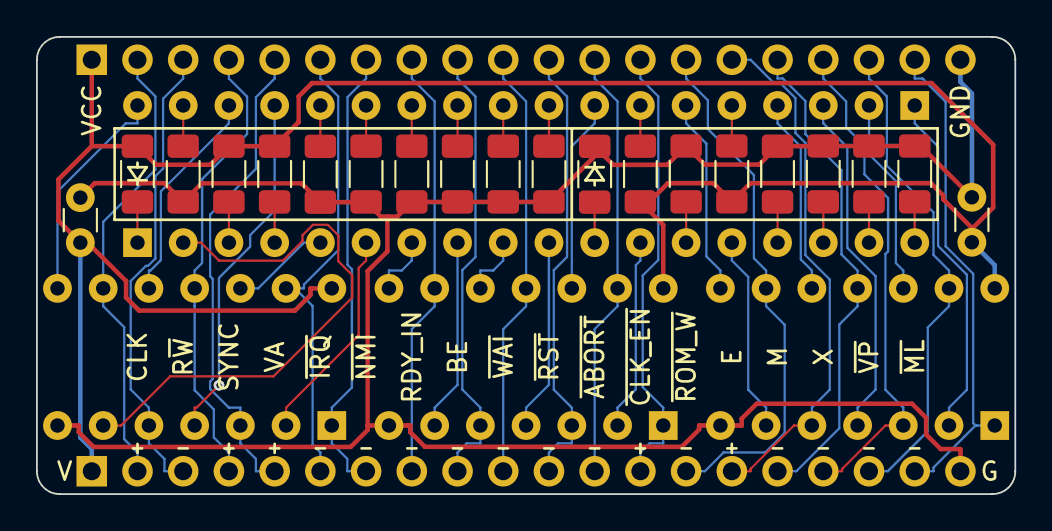
[picture p71: board debug_leds.kicad_pcb from above]

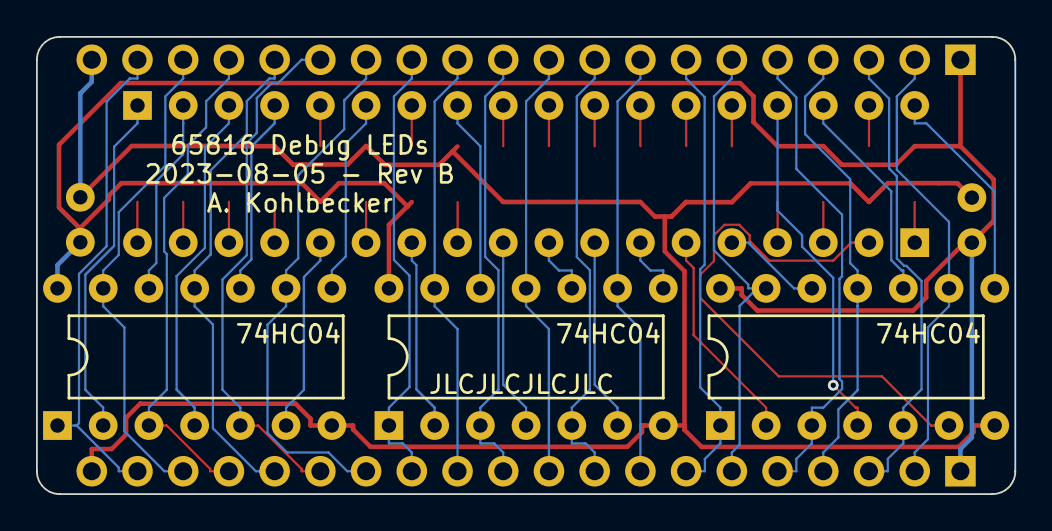
[picture p72: board debug_leds.kicad_pcb from below]

Board: 2 copper layers, 54.4 x 25.4 mm, 27 parts (5 on the bottom side), 56 nets.
