adrienkohlbecker/BB816/(commit log)

2021-07-20 Schematic start and bank address latching circuit
    [65816.kicad_pcb, 65816.sch]
2021-07-24 Don't forget the "C" in 65C816
    [65816.kicad_pcb, 65C816.kicad_pcb, 65C816.sch]
2021-07-31 Add data pins buffer and pull downs
    [65C816.sch]
2021-08-08 Add Bus Enable to the logic for data bus buffer & bank address latch
    [65C816.sch]
2021-08-20 Add pull up/down resistors, project symbol library
    [65C816.sch]
2021-08-20 Add BOM
2021-09-03 Update for episode 5
    [65C816.sch]
2021-09-27 Update for episode 6
    [65C816.sch]
2021-10-21 Updates for episode 7
    [65C816.sch]
2021-11-09 Updates for episode 8
    [65C816.sch, clock.sch]
2021-11-16 Updates for episode 9
    [65C816.sch, clock.sch]
2021-11-19 Add basics BOM
2021-11-24 Update for episode 10
    [65C816.sch, clock.sch, reset.sch]
2021-11-24 Update for ep 11
    [clock.sch]
2021-11-24 Re-number parts
    [65C816.sch, clock.sch, reset.sch]
2021-11-24 Add version info
    [65C816.sch, clock.sch, reset.sch]
2021-11-29 More episode 11 updates
    [65C816.sch, clock.sch, reset.sch]
2021-12-01 More updates for ep 11
    [clock.sch]
2021-12-10 Updates for Episode 12
    [65C816.sch, clock.sch, debug.sch, reset.sch, tester.sch]
2021-12-14 Annotate tester
    [tester.sch]
2022-01-03 Update to KiCad 6
    [65C816.kicad_pcb, 65C816.kicad_sch, 65C816.sch, clock.kicad_sch, clock.sch, debug.kicad_sch, debug.sch, reset.kicad_sch]
2022-01-13 Updates for Episode 13
    [65C816.kicad_sch, clock.kicad_sch, debug.kicad_sch, reset.kicad_sch, tester.kicad_sch]
2022-01-15 Updates for Episode 14
    [65C816.kicad_sch, address_decoding.kicad_sch, clock.kicad_sch, debug.kicad_sch, glue_logic.kicad_sch, memory.kicad_sch, reset.kicad_sch, tester.kicad_sch]
2022-01-16 Fix gate
    [65C816.kicad_sch, glue_logic.kicad_sch]
2022-01-16 FIx tester
    [65C816.kicad_sch, tester.kicad_sch]
2022-01-16 More updates for episode 14
    [65C816.kicad_sch, address_decoding.kicad_sch, clock.kicad_sch]
2022-01-26 Start episode 15
    [65C816.kicad_sch, address_decoding.kicad_sch, clock.kicad_sch, debug.kicad_sch, glue_logic.kicad_sch, memory.kicad_sch, reset.kicad_sch, tester.kicad_sch]
2022-01-28 Update for Episode 15
    [65C816.kicad_sch, glue_logic.kicad_sch, memory.kicad_sch]
2022-02-01 Update for Episode 16
    [65C816.kicad_sch, address_decoding.kicad_sch, clock.kicad_sch, debug.kicad_sch, glue_logic.kicad_sch, memory.kicad_sch, reset.kicad_sch, tester.kicad_sch]
2022-02-01 Update schematics
    [65C816.kicad_sch]
2022-02-18 Updates for episode 17
    [65C816.kicad_sch, address_decoding.kicad_sch, clock.kicad_sch, debug.kicad_sch, glue_logic.kicad_sch, memory.kicad_sch, monitor.kicad_sch, reset.kicad_sch]
2022-02-24 Update for episode 18
    [65C816.kicad_sch, address_decoding.kicad_sch, clock.kicad_sch, debug.kicad_sch, glue_logic.kicad_sch, memory.kicad_sch, monitor.kicad_sch, reset.kicad_sch]
2022-03-02 Update for episode 19
    [65C816.kicad_sch, address_decoding.kicad_sch, clock.kicad_sch, debug.kicad_sch, glue_logic.kicad_sch, memory.kicad_sch, monitor.kicad_sch, reset.kicad_sch]
2022-03-07 More episode 19 updates
    [65C816.kicad_sch, glue_logic.kicad_sch, memory.kicad_sch, monitor.kicad_sch]
2022-03-20 More updates for Episode 19
    [glue_logic.kicad_sch]
2022-03-28 Update for episode 20
    [65C816.kicad_sch, address_decoding.kicad_sch, clock.kicad_sch, debug.kicad_sch, glue_logic.kicad_sch, memory.kicad_sch, monitor.kicad_sch, reset.kicad_sch]
2022-04-01 Updates for episode 20
    [65C816.kicad_sch, clock.kicad_sch, monitor.kicad_sch, reset.kicad_sch]
2022-04-18 Update for episode 21
    [65C816.kicad_sch, address_decoding.kicad_sch, clock.kicad_sch, debug.kicad_sch, glue_logic.kicad_sch, gpio.kicad_sch, memory.kicad_sch, monitor.kicad_sch]
2022-05-01 More episode 21 update
    [65C816.kicad_sch, debug.kicad_sch]
2022-05-23 Updates for episode 22
    [65C816.kicad_sch, address_decoding.kicad_sch, clock.kicad_sch, debug.kicad_sch, glue_logic.kicad_sch, gpio.kicad_sch, memory.kicad_sch, monitor.kicad_sch]
2022-05-23 Update for episode 23
    [65C816.kicad_sch, address_decoding.kicad_sch, clock.kicad_sch, debug.kicad_sch, glue_logic.kicad_sch, gpio.kicad_sch, memory.kicad_sch, monitor.kicad_sch]
2022-07-12 Snapshot ep 24 work
    [65C816.kicad_sch, address_decoding.kicad_sch, breakout.kicad_sch, clock_reset.kicad_sch, debug.kicad_sch, debug_clock.kicad_sch, glue_logic.kicad_sch, gpio.kicad_sch]
2022-07-20 More updates
    [65C816.kicad_sch, breakout.kicad_sch, clock_reset.kicad_sch, debug_clock.kicad_sch, glue_logic.kicad_sch, gpio.kicad_sch, monitor.kicad_sch]
2022-07-29 Updates for episode 25
    [65C816.kicad_sch, address_decoding.kicad_sch, breakout.kicad_sch, clock_reset.kicad_sch, debug.kicad_sch, debug_clock.kicad_sch, glue_logic.kicad_sch, gpio.kicad_sch]
2022-07-29 breakout project
    [breakout.kicad_pcb, breakout.kicad_sch, clock_reset.kicad_sch, glue_logic.kicad_sch]
2022-07-30 Update main project
    [65C816.kicad_sch, address_decoding.kicad_sch, breakout.kicad_sch, clock_reset.kicad_sch, debug.kicad_sch, debug_clock.kicad_sch, glue_logic.kicad_sch, gpio.kicad_sch]
2022-07-30 More updates for episode 25
    [65C816.kicad_sch]
2022-07-30 Episode 25
    [65C816.kicad_sch, breakout.kicad_sch, clock_reset.kicad_sch, glue_logic.kicad_sch, monitor.kicad_sch]
2022-08-01 Move breakout to single sheet
    [breakout.kicad_sch, clock_reset.kicad_sch, glue_logic.kicad_sch]
2022-08-20 Update breakout
    [breakout-B_Cu.gbl, breakout-B_Mask.gbs, breakout-B_Paste.gbp, breakout-B_Silkscreen.gbo, breakout-Edge_Cuts.gm1, breakout-F_Cu.gtl, breakout-F_Mask.gts, breakout-F_Paste.gtp]
2022-09-01 Update gerbers
    [breakout-B_Cu.gbl, breakout-B_Mask.gbs, breakout-B_Paste.gbp, breakout-B_Silkscreen.gbo, breakout-Edge_Cuts.gm1, breakout-F_Cu.gtl, breakout-F_Mask.gts, breakout-F_Paste.gtp]
2022-09-04 Prep ep 28
    [65C816.kicad_pcb, 65C816.kicad_sch, address_decoding.kicad_sch, breakout.kicad_sch, debug.kicad_sch, debug_clock.kicad_sch, gpio.kicad_sch, memory.kicad_sch]
2022-09-04 Add PIN and PORT registers
2022-09-04 Implement data polling
    [65C816.kicad_sch, monitor.kicad_sch]
2022-10-21 Add 65C51
    [65C816.kicad_sch, address_decoding.kicad_sch, debug.kicad_sch, debug_clock.kicad_sch, gpio.kicad_sch, memory.kicad_sch, monitor.kicad_sch, peripherals.kicad_sch]
2022-10-21 Update serial schematic
    [serial.kicad_sch]
2022-10-21 Fix serial bug
    [65C816.kicad_sch, serial.kicad_sch]
2022-10-23 Episode 30
    [65C816.kicad_sch, serial.kicad_sch]
2022-10-23 Update for ep 30
    [65C816.kicad_sch, serial.kicad_sch]
2022-11-09 Add reset from monitor
    [monitor.ino]
2022-11-09 Switch to toggle bit
2023-01-19 Show Teensy output during programming
2023-01-19 Don't print report
2023-05-14 Switch monitor to PlatformIO
2023-05-14 Add printing mnemonics
2023-05-14 Trace optimizations
2023-05-14 Update kicad
    [65C816.kicad_sch]
2023-05-14 Update schematic
    [65C816.kicad_sch, address_decoding.kicad_sch, debug.kicad_sch, debug_clock.kicad_sch, gpio.kicad_sch, memory.kicad_sch, monitor.kicad_sch, peripherals.kicad_sch]
2023-05-14 Default VIA to output low for blank LEDs
2023-05-14 Fix assembler warnings
2023-05-14 Update for Episode 32
    [65C816.kicad_sch, address_decoding.kicad_sch, debug.kicad_sch, debug_clock.kicad_sch, gpio.kicad_sch, memory.kicad_sch, monitor.kicad_sch, peripherals.kicad_sch]
2023-05-23 Fix BOM
    [65C816.kicad_sch, serial.kicad_sch]
2023-08-10 Fix hexDigitToNumber with lowercase input
    [monitor.cpp]
2023-08-10 Add debug LEDs PCB
    [debug_leds-B_Cu.gbl, debug_leds-B_Mask.gbs, debug_leds-B_Paste.gbp, debug_leds-B_Silkscreen.gbo, debug_leds-Edge_Cuts.gm1, debug_leds-F_Cu.gtl, debug_leds-F_Mask.gts, debug_leds-F_Paste.gtp]
2023-08-10 Update debug leds
    [BAR-10-BRYG.step, BAR-8-RYG.step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]
2023-08-10 Kicad 7
    [BB816.kicad_pcb, BB816.kicad_sch, address_decoding.kicad_sch, breakout.kicad_sch, debug.kicad_sch, debug_clock.kicad_sch, gpio.kicad_sch, memory.kicad_sch]
