adrienkohlbecker/BB816/(notices)

Notices in the files:
hardware/debug_leds/debug_leds.kicad_sch:
Licensed under CERN-OHL-W v2
Copyright © 2022 Adrien Kohlbecker
hardware/gpio.kicad_sch:
Copyright © 2022-2023 Adrien Kohlbecker
hardware/65816.sch:
Copyright © 2021 Adrien Kohlbecker
